flogothetis/Low-power-GPS-tracker-for-Alzhaimer-Patients/README.md

alz

Read the report of the project.
